gelassal/Fault-Tolerant-STM32-Motor-Controller/results/evidence/driver-power-001/reverse-pwm-10-percent.jpg

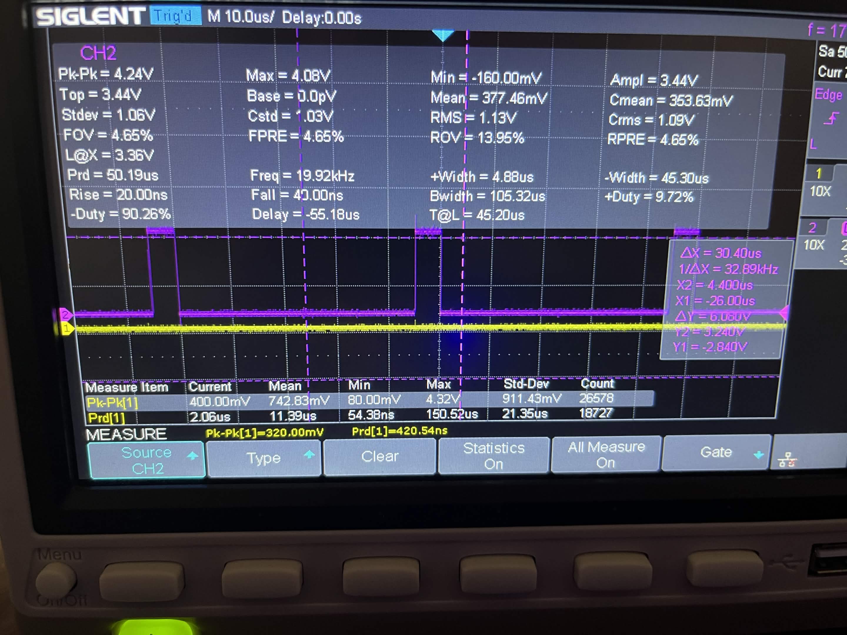
results/evidence/driver-power-001/reverse-pwm-10-percent.jpg
