gelassal/Fault-Tolerant-STM32-Motor-Controller/results/evidence/driver-power-001/forward-pwm-20-percent.jpg

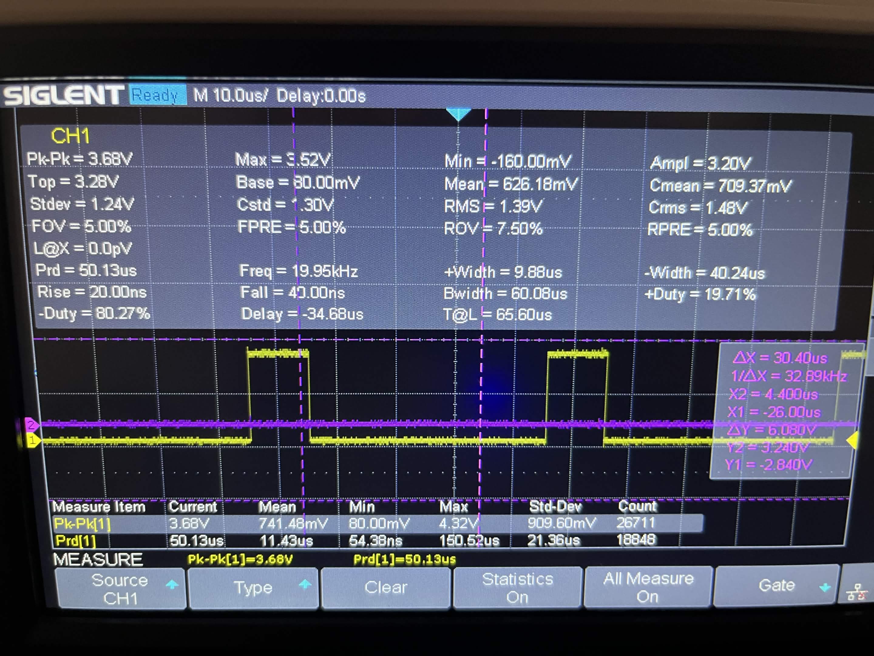
results/evidence/driver-power-001/forward-pwm-20-percent.jpg
