gelassal/Fault-Tolerant-STM32-Motor-Controller/README.md

# Fault-Tolerant STM32 Motor-Control Platform

A safety-oriented brushed-DC motor controller built on the STM32F446RE. The
project is intended to demonstrate professional embedded-firmware architecture,
hardware bring-up, real-time control, fault handling, communication, and
automated validation using measured results.

## Current Status

The open-loop safety layer has now been validated through fused carrier power,
bidirectional unloaded motor operation, and physical software-fault shutdown.
The active milestone is exposing and validating the existing encoder
measurement subsystem on real hardware.

Completed in firmware:

- NUCLEO-F446RE board, debugger, LED, and USART2 bring-up
- Interrupt-driven UART command console at 115200 baud
- TIM4_CH1 and TIM8_CH2 dual-PWM outputs configured for a calculated 20 kHz
- Low-level TB9051FTG motor-driver abstraction
- High-level disabled, ready, running, braking, and fault state machine
- READY and brake-release semantics that leave the H-bridge disabled to coast
- Direction interlock, latched faults, explicit fault clearing, and software
  fault injection
- Native state-machine regression suite with a mocked motor driver
- TIM3 quadrature encoder mode on PB4/PB5 with 16-bit wrap handling
- Nonblocking 10 ms encoder sampling, continuous count, RPM, and direction
- HAL-free encoder-math regression suite using the exact 3,591.84 output-shaft
  counts per revolution of Pololu #4866
- Read-only `encoder` UART telemetry with signed count, delta, fixed-point RPM,
  and encoder direction
- Python UART HIL smoke-test skeleton for repeatable safety-state validation

Verified through 2026-08-19:

- All 147 native motor-controller assertions passed with `-Wall -Wextra
  -Werror -pedantic`.
- All 57 native encoder assertions passed with the same strict warnings.
- All 4 Python UART parser/read-only-mode tests passed.
- Physical Nucleo UART safety-state behavior and the carrier's VIN-absent DIAG
  fault path were validated.
- A complete STM32 Debug rebuild compiled and linked with zero warnings.
- Encoder-telemetry firmware image size: 29,100 bytes text, 100 bytes
  initialized data, and 2,384 bytes BSS.
- DRIVER-POWER-001 passed at 12.0 V with a 0.25 A current limit, approximately
  0.002 A unloaded current, and measured 19.90-19.95 kHz PWM.
- MOTOR-SPIN-001 passed at a lowest reliable 12% starting duty in both
  directions, approximately 0.036 A running current, and verified software-fault
  coast and latch behavior.

Not yet physically verified:

- Physical encoder signals and direction polarity
- Current sensing, closed-loop control, FreeRTOS, CAN, and executed HIL tests

## Hardware

- ST NUCLEO-F446RE
- Pololu #2997 TB9051FTG single brushed-DC motor-driver carrier
- Pololu #4866 75:1 MP 12 V 25D gearmotor with 48 CPR encoder
- Protected, current-limited 12 V bench supply and physical cutoff (required
  before powered testing)

See [docs/wiring.md](docs/wiring.md) for the exact pin map, equipment gate, and
staged bring-up procedure.

## Architecture

UART commands pass through `motor_controller`, which enforces application
policy before using the low-level `motor_driver`. The console cannot directly
enable the H-bridge or change PWM.

```text
USART2 interrupt -> command buffer -> command parser
                                      |
                                      v
                               motor_controller
                                      |
                                      v
                                 motor_driver
                                      |
                                      v
                         GPIO + PWM + TB9051FTG
```

The current synchronous main loop is intentional. Encoder feedback and
closed-loop behavior will be validated before the application is migrated to
FreeRTOS tasks.

## Native Tests

Run both native suites:

```powershell
mingw32-make -C tests\motor_controller run
mingw32-make -C tests\encoder run
```

The controller tests use a fake motor driver to verify state policy and fault
handling. The encoder tests feed synthetic counter values into production math
to verify signed motion, zero speed, rollover, high count rates, accumulated
position, direction inversion, and RPM conversion.

Run the Python UART parsing and read-only-mode tests:

```powershell
python tools\hil\test_uart_smoke_test.py
```

After flashing, query encoder telemetry manually with `encoder` or run the
read-only integration check described in `tools/hil/README.md`.

## Long-Term Target

The resume-ready target is an encoder-based 1 kHz closed-loop controller with
FreeRTOS timing measurements, ADC/DMA current monitoring, CAN commands and
telemetry, multiple detected fault conditions, Python HIL automation, CI, and
recorded performance data. A custom carrier PCB and bootloader remain optional
stretch goals after the development-board system is validated.

## Safety and Measurement Policy

- Reset, disable, and fault states must force zero PWM and disable the driver.
- READY means armed but electrically coasting; BRAKING is the deliberate
  short-brake state.
- Never connect 12 V to a Nucleo logic or 5 V pin.
- Do not use Dupont wires or a solderless breadboard for motor current.
- Do not power the motor until the equipment checklist and motor-disconnected
  tests pass.
- Do not publish performance claims without saved test records.

Curated scope captures and motor-test summaries are stored under
`results/evidence/`; bulk raw captures remain intentionally ignored.
