gelassal/Fault-Tolerant-STM32-Motor-Controller/results/evidence/uart-fault-validation.png

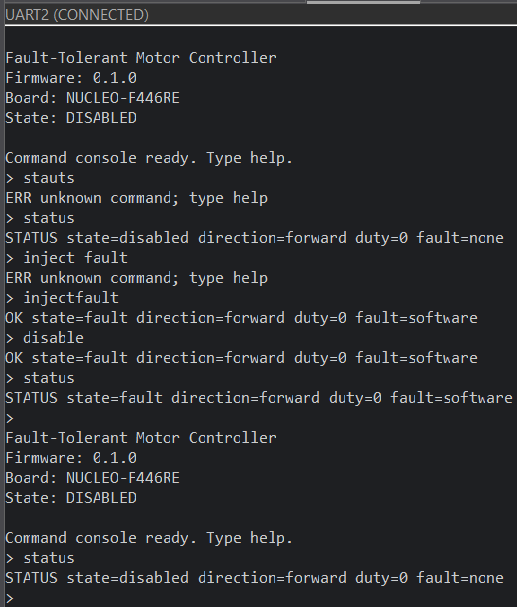
results/evidence/uart-fault-validation.png
