gelassal/Fault-Tolerant-STM32-Motor-Controller/firmware/control_node/Core/Src/main.c

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
/* Includes ------------------------------------------------------------------*/
#include "main.h"

/* USER CODE BEGIN Includes */
#include "command_console.h"
#include "encoder_driver.h"
#include "motor_controller.h"
#include "motor_driver.h"
/* USER CODE END Includes */

/* USER CODE BEGIN PD */
#define MOTOR_ENCODER_COUNTS_PER_OUTPUT_REVOLUTION 3591.84f
#define ENCODER_SAMPLE_PERIOD_MS                   10U

/* USER CODE END PD */



TIM_HandleTypeDef htim3;
TIM_HandleTypeDef htim4;
TIM_HandleTypeDef htim8;

UART_HandleTypeDef huart2;

void SystemClock_Config(void);
static void MX_GPIO_Init(void);
static void MX_USART2_UART_Init(void);
static void MX_TIM3_Init(void);
static void MX_TIM4_Init(void);
static void MX_TIM8_Init(void);
/**
  * @brief  The application entry point.
  * @retval int
  */
int main(void)
{

  /* MCU Configuration--------------------------------------------------------*/

  /* Reset of all peripherals, Initializes the Flash interface and the Systick. */
  HAL_Init();

  /* Configure the system clock */
  SystemClock_Config();

  /* Initialize all configured peripherals */
  MX_GPIO_Init();
  MX_USART2_UART_Init();
  MX_TIM3_Init();
  MX_TIM4_Init();
  MX_TIM8_Init();
  /* USER CODE BEGIN 2 */

  const uint8_t boot_message[] =
      "\r\n"
      "Fault-Tolerant Motor Controller\r\n"
      "Firmware: 0.1.0\r\n"
      "Board: NUCLEO-F446RE\r\n"
      "State: DISABLED\r\n";

  HAL_UART_Transmit(
      &huart2,
      (uint8_t *)boot_message,
      sizeof(boot_message) - 1U,
      HAL_MAX_DELAY
  );

  MotorDriverConfig_t motor_driver_config =
  {
      .pwm1_timer = &htim4,
      .pwm1_channel = TIM_CHANNEL_1,

      .pwm2_timer = &htim8,
      .pwm2_channel = TIM_CHANNEL_2,

      .enable_port = MOTOR_EN_GPIO_Port,
      .enable_pin = MOTOR_EN_Pin,

      .enable_bar_port = MOTOR_ENB_GPIO_Port,
      .enable_bar_pin = MOTOR_ENB_Pin,

      .diag_port = MOTOR_DIAG_GPIO_Port,
      .diag_pin = MOTOR_DIAG_Pin
  };

  if (MotorDriver_Init(&motor_driver_config) != MOTOR_STATUS_OK)
  {
      Error_Handler();
  }

  if (MotorController_Init() != MOTOR_CONTROLLER_STATUS_OK)
  {
      Error_Handler();
  }

  EncoderConfig_t encoder_config =
  {
      .timer = &htim3,
      .counts_per_output_revolution =
          MOTOR_ENCODER_COUNTS_PER_OUTPUT_REVOLUTION,
      .sample_period_ms = ENCODER_SAMPLE_PERIOD_MS,
      .invert_direction = false
  };

  if (Encoder_Init(
          &encoder_config,
          HAL_GetTick()) != ENCODER_STATUS_OK)
  {
      Error_Handler();
  }

  if (!CommandConsole_Init(&huart2))
  {
      Error_Handler();
  }

  uint32_t last_led_toggle_ms = HAL_GetTick();

  /* USER CODE END 2 */

  /* Initialize leds */
  BSP_LED_Init(LED2);

  /* Initialize USER push-button, will be used to trigger an interrupt each time it's pressed.*/
  BSP_PB_Init(BUTTON_USER, BUTTON_MODE_EXTI);

  /* Infinite loop */
  /* USER CODE BEGIN WHILE */
  while (1)
  {
    if (Encoder_Process(HAL_GetTick()) != ENCODER_STATUS_OK)
    {
      Error_Handler();
    }

    MotorController_Process();
    CommandConsole_Process();

    if ((HAL_GetTick() - last_led_toggle_ms) >= 500U)
    {
      last_led_toggle_ms = HAL_GetTick();
      HAL_GPIO_TogglePin(GPIOA, GPIO_PIN_5);
    }

    /* USER CODE END WHILE */

    /* USER CODE BEGIN 3 */
  }
  /* USER CODE END 3 */
}

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
/* USER CODE BEGIN 4 */

void HAL_UART_RxCpltCallback(
    UART_HandleTypeDef *huart)
{
    CommandConsole_OnRxComplete(huart);
}

/* USER CODE END 4 */
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
