gelassal/Fault-Tolerant-STM32-Motor-Controller/firmware/control_node/Core/Inc/main.h

#define USART_TX_Pin GPIO_PIN_2
#define USART_TX_GPIO_Port GPIOA
#define USART_RX_Pin GPIO_PIN_3
#define USART_RX_GPIO_Port GPIOA
#define MOTOR_DIAG_Pin GPIO_PIN_10
#define MOTOR_DIAG_GPIO_Port GPIOB
#define MOTOR_EN_Pin GPIO_PIN_8
#define MOTOR_EN_GPIO_Port GPIOA
#define MOTOR_ENB_Pin GPIO_PIN_10
#define MOTOR_ENB_GPIO_Port GPIOA
#define TMS_Pin GPIO_PIN_13
#define TMS_GPIO_Port GPIOA
#define TCK_Pin GPIO_PIN_14
#define TCK_GPIO_Port GPIOA
#define SWO_Pin GPIO_PIN_3
#define SWO_GPIO_Port GPIOB
#define ENCODER_A_Pin GPIO_PIN_4
#define ENCODER_A_GPIO_Port GPIOB
#define ENCODER_B_Pin GPIO_PIN_5
#define ENCODER_B_GPIO_Port GPIOB
