gelassal/Fault-Tolerant-STM32-Motor-Controller/(commit log)

2026-07-24 Initialize motor-control project structure and requirements
2026-07-27 Add STM32F446 board bring-up and LED blink
2026-07-27 Add UART boot diagnostics and verify debugger bring-up
2026-08-04 Validate motor driver duty and direction logic
2026-08-04 Configure and validate 20 kHz dual-PWM motor control
2026-08-04 Add interrupt-driven UART motor command console
2026-08-07 Integrate motor safety state machine with UART commands
2026-08-14 Add TIM3 encoder measurement and dynamic UART status
2026-08-14 Record UART fault validation and power-test readiness
2026-08-14 Prepare powered motor driver validation
2026-08-19 Record powered driver and first motor-spin validation
2026-08-19 Expose encoder telemetry over UART
2026-08-20 Fix encoder telemetry formatting on target
    [command_console.c]
