gelassal/Fault-Tolerant-STM32-Motor-Controller/(notices)

Notices in the files:
firmware/control_node/Core/Src/main.c:
Copyright (c) 2026 STMicroelectronics.
All rights reserved.
This software is licensed under terms that can be found in the LICENSE file
